Modellbahn-Treff/OtterPlus_StepperBaustein/hardware/StepperBaustein.kicad_pcb

## KiCad design hardware/StepperBaustein.kicad_pcb (2026-05-02)

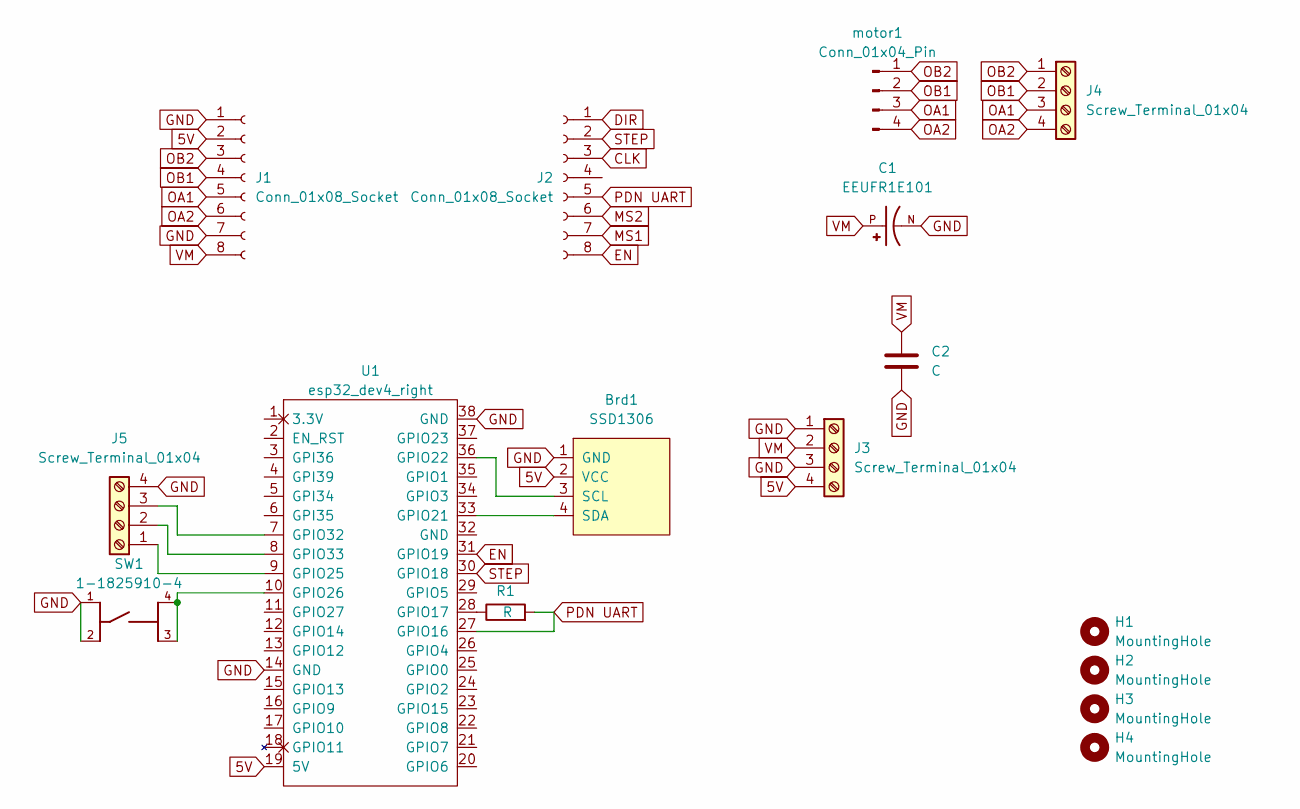
[picture p1: schematic StepperBaustein.kicad_sch]

Parts:
Brd1: SSD1306; 128x64OLED
C1: EEUFR1E101; CAPPRD250W50D630H1120; PARTREV 28-FEB-20
C2: C; C_0805_2012Metric_Pad1.18x1.45mm_HandSolder
H1, H2, H3, H4: MountingHole; MountingHole_3.2mm_M3
J1, J2: Conn_01x08_Socket; PinSocket_1x08_P2.54mm_Vertical
J3, J4, J5: Screw_Terminal_01x04; 1729144
R1: R; R_0805_2012Metric_Pad1.20x1.40mm_HandSolder
SW1: 1-1825910-4; TE_1-1825910-4; PARTREV C10
U1: esp32_dev4_right
U2: esp32_dev4_left; esp32_dev_left
motor1: Conn_01x04_Pin; PinSocket_1x04_P2.54mm_Vertical

Connections:
5V: Brd1.2 (VCC), J1.2, J3.4, U2.19 (5V)
CLK: J2.3
DIR: J2.1
EN: J2.8, U1.31 (GPIO19)
GND: Brd1.1 (GND), C1.N, C2.2, J1.1, J1.7, J3.1, J3.3, J5.4, SW1.1, SW1.2, U1.38 (GND), U2.14 (GND)
MS1: J2.7
MS2: J2.6
unnamed: Brd1.3 (SCL), U1.36 (GPIO22)
unnamed: Brd1.4 (SDA), U1.33 (GPIO21)
unnamed: J5.1, U2.9 (GPIO25)
unnamed: J5.2, U2.8 (GPIO33)
unnamed: J5.3, U2.7 (GPIO32)
unnamed: R1.1, U1.28 (GPIO17)
unnamed: SW1.3, SW1.4, U2.10 (GPIO26)
OA1: J1.5, J4.3, motor1.3
OA2: J1.6, J4.4, motor1.4
OB1: J1.4, J4.2, motor1.2
OB2: J1.3, J4.1, motor1.1
PDN UART: J2.5, R1.2, U1.27 (GPIO16)
STEP: J2.2, U1.30 (GPIO18)
VM: C1.P, C2.1, J1.8, J3.2

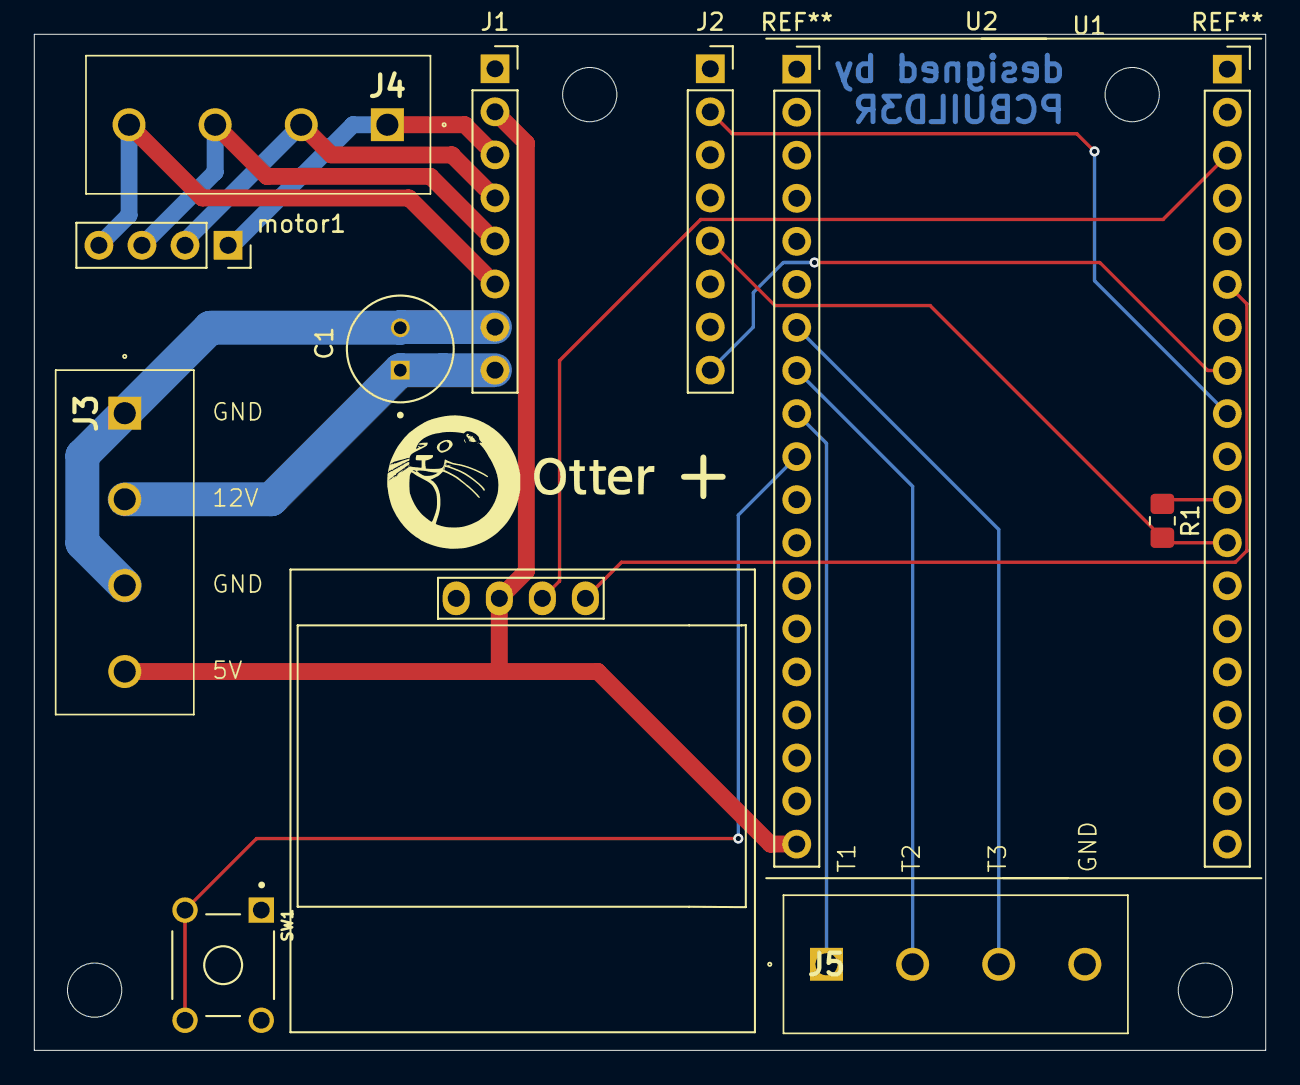
[picture p2: board StepperBaustein.kicad_pcb from above]

Board: 2 copper layers, 72.6 x 59.9 mm, 17 parts (1 on the bottom side), 17 nets.
