Modellbahn-Treff/OtterPlus_StepperBaustein/(commit log)

2026-06-20 create firmware folder
    [StepperBaustein.kicad_pcb, StepperBaustein.kicad_sch]
2026-06-27 Fix gpio input configuration type
    [gpio_inputs.cpp]
